sasha-nordiclab/noritsu-repair-parts/roller/README.md

# Noritsu QSF-V50 rack roller

Replacement film transport roller for the racks of the Noritsu QSF-V50 film processor. It is made of two printed parts:

- **Core (PETG):** the roller body on a Ø6 mm shaft, with end flanges and eight anti-rotation ribs.
- **Sleeve (TPU):** the rubber covering with a raised diamond grid, printed flat as a sheet and wrapped onto the core.

> **Status:** designed and checked in CAD (fits, overhangs, slicing). Not yet print-tested in the machine.

<p align="center">
  Assembled roller: PETG core with grid-textured TPU sleeve
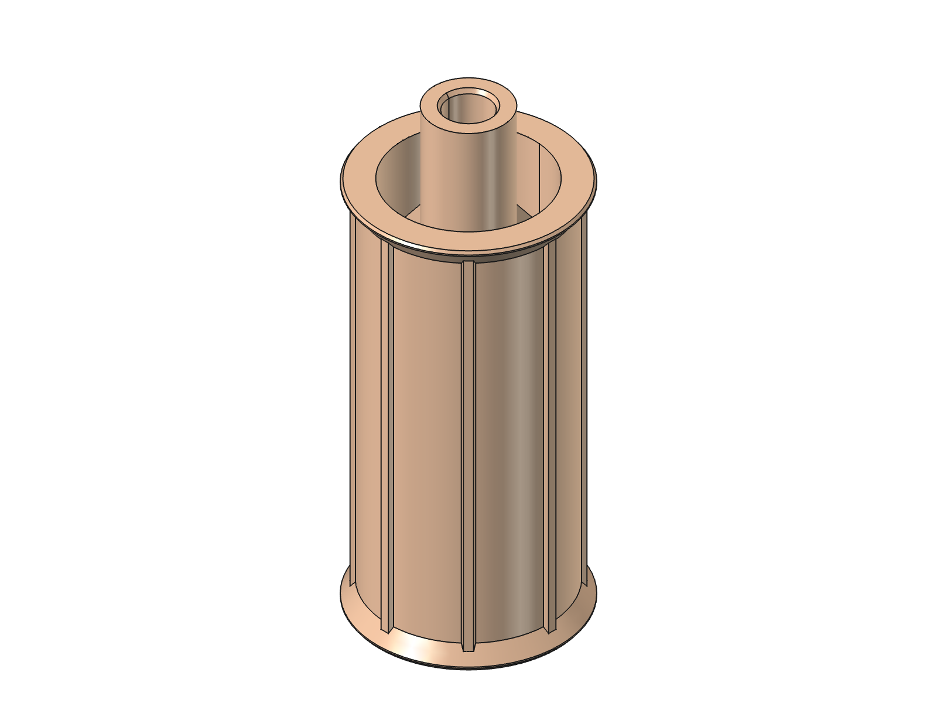
[picture p2: roller/docs/img/core_petg.png]
PETG core with eight grip ribs
  
</p>

## Files

| File | Use |
|---|---|
| [`step/Noritsu_V50_Roller_Core_PETG.step`](step/Noritsu_V50_Roller_Core_PETG.step) | Print: PETG core |
| [`step/Noritsu_V50_Roller_Sleeve_TPU_Flat.step`](step/Noritsu_V50_Roller_Sleeve_TPU_Flat.step) | Print: TPU sleeve as a flat sheet |
| [`step/Noritsu_V50_Roller_Assembly.step`](step/Noritsu_V50_Roller_Assembly.step) | Reference: core with the fitted, textured sleeve |
| [`step/Noritsu_V50_Roller_Sleeve_TPU_Fitted.step`](step/Noritsu_V50_Roller_Sleeve_TPU_Fitted.step) | Reference: the sleeve as it sits on the core |
| [`step/Noritsu_V50_Roller_Design_Reference.step`](step/Noritsu_V50_Roller_Design_Reference.step) | Reference: the original roller geometry before print optimisation (1 mm mid-length partition, Ø6 bore) |
| [`step/Noritsu_V50_Original_Sleeve_TPU_Flat.step`](step/Noritsu_V50_Original_Sleeve_TPU_Flat.step) | Print: TPU sleeve for the original roller, flat sheet |
| [`step/Noritsu_V50_Original_Assembly.step`](step/Noritsu_V50_Original_Assembly.step) | Reference: original roller with its fitted, textured sleeve |
| [`step/Noritsu_V50_Original_Sleeve_TPU_Fitted.step`](step/Noritsu_V50_Original_Sleeve_TPU_Fitted.step) | Reference: that sleeve as it sits on the original roller |
| [`step/Noritsu_V50_Roller_Sleeve_TPU_Smooth_Flat.step`](step/Noritsu_V50_Roller_Sleeve_TPU_Smooth_Flat.step) | Print: smooth TPU sleeve (no grid), flat sheet |
| [`step/Noritsu_V50_Original_Sleeve_TPU_Smooth_Flat.step`](step/Noritsu_V50_Original_Sleeve_TPU_Smooth_Flat.step) | Print: smooth TPU sleeve for the original roller, flat sheet |
| [`step/Noritsu_V50_Roller_Smooth_Assembly.step`](step/Noritsu_V50_Roller_Smooth_Assembly.step) · [`step/Noritsu_V50_Original_Smooth_Assembly.step`](step/Noritsu_V50_Original_Smooth_Assembly.step) | Reference: both rollers with the smooth sleeve fitted |
| [`step/Noritsu_V50_Roller_Dovetail_Core_PETG.step`](step/Noritsu_V50_Roller_Dovetail_Core_PETG.step) | Print: PETG core with dovetail slot |
| [`step/Noritsu_V50_Roller_Dovetail_Sleeve_TPU_Flat.step`](step/Noritsu_V50_Roller_Dovetail_Sleeve_TPU_Flat.step) | Print: smooth TPU sleeve with dovetail ends, flat sheet |
| [`step/Noritsu_V50_Roller_Dovetail_Assembly.step`](step/Noritsu_V50_Roller_Dovetail_Assembly.step) | Reference: dovetail core with the sleeve fitted |
| [`cad/NoritsuV50_Roller.FCStd`](cad/NoritsuV50_Roller.FCStd) | Parametric FreeCAD model with all of the above |

## Main dimensions

| | |
|---|---|
| Shaft / bore | Ø6 mm shaft, Ø6.5 mm printed bore (free running) |
| Running diameter | Ø26.5 mm core, about Ø30.9 mm over the grid |
| Flanges | Ø30 mm, 0.6 mm thick, 40° cones underneath |
| Length | 60 mm between flange faces, 70.4 mm with the hub stub |
| Hub | Ø11.3 mm, 2.4 mm wall; free for 5 mm at both ends (end recesses) |
| Grip ribs | 8 × trapezoid, 1.8 mm base, 1.2 mm top, 0.6 mm high |
| Sleeve | 1.2 mm base + 1 mm raised diamond grid: ribs 1.2 mm wide (2 lines of 0.6 mm) at ±45°, 3 mm pitch, 21 cells around |

## Core (PETG)

<p align="center">
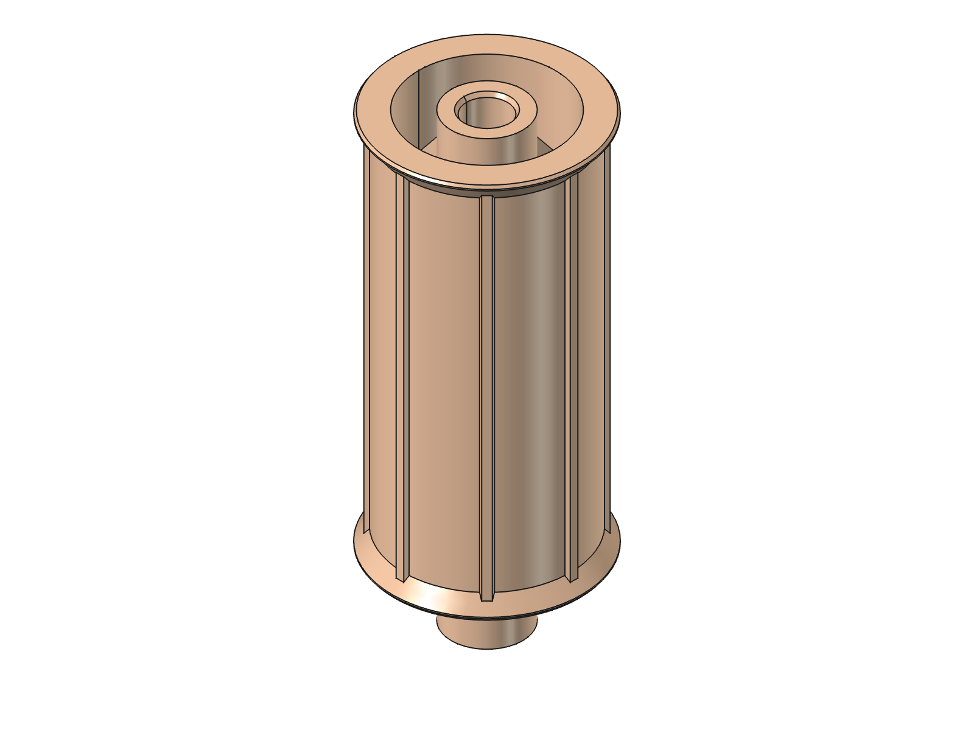
[picture p3: roller/docs/img/core_petg_bottom.png]
Core seen from the bottom end: end recess around the hub and spokes
  
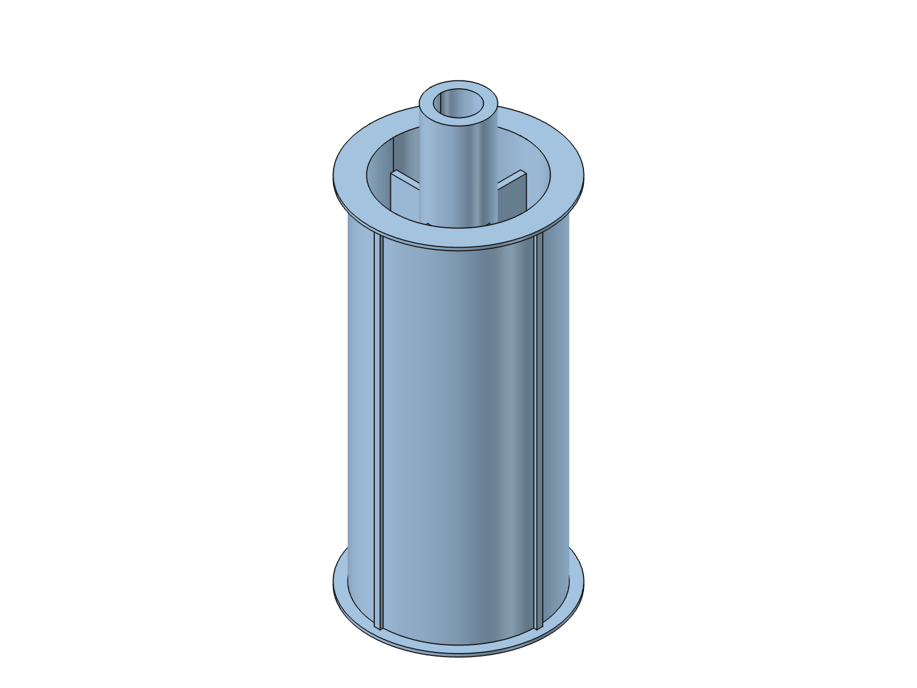
[picture p4: roller/docs/img/design_reference.png]
Original roller design before print optimisation
  
</p>

- **Orientation:** bottom end face on the bed, roller axis vertical. No supports: every overhang is 40° or less from vertical.
- **Inside:** four spokes join the hub to a 2.4 mm shell. A 2 mm web at mid-length closes the cavities; its underside is a tapered roof, so it prints without bridging. The 5 mm end recesses around the hub are the same depth at both ends.
- **Slicing (measured):** OrcaSlicer, Bambu Lab A1 0.4 nozzle, *0.20mm NordicLab 0.6 Ballance*, AzureFilm PETG HF: **1 h 25 min, 24.6 g**. The walls are all perimeters, so forcing solid walls does not change the result.

## Sleeve (TPU)

<p align="center">
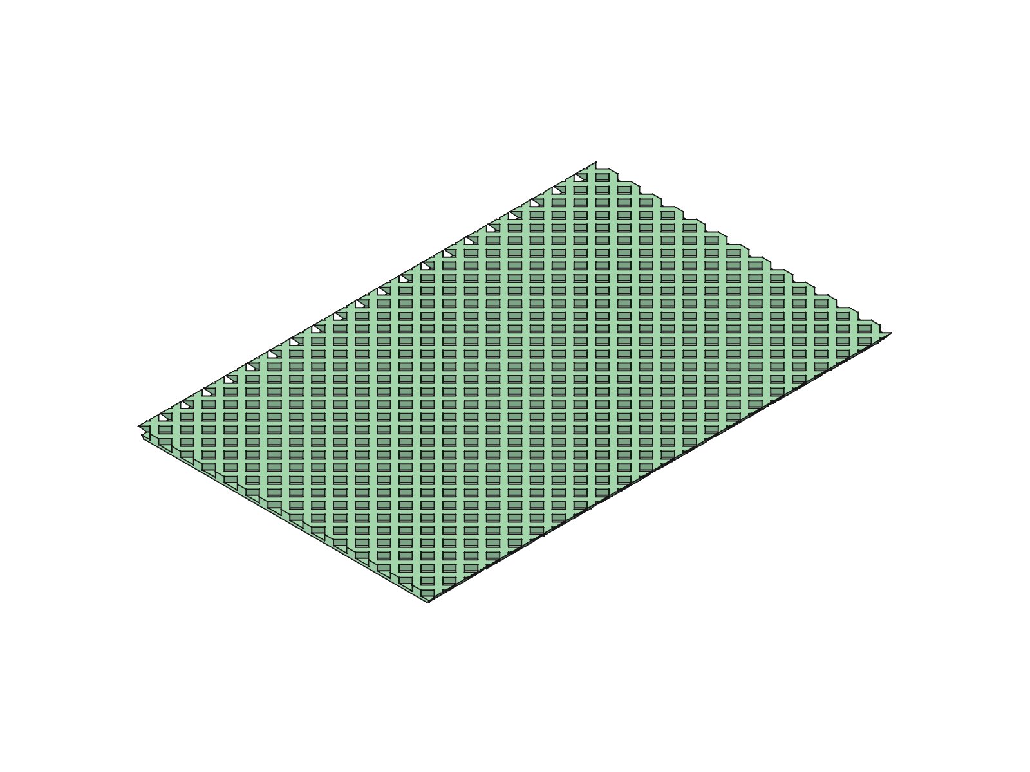
[picture p5: roller/docs/img/sleeve_flat_tpu.png]
Flat TPU sheet with raised diamond grid
  
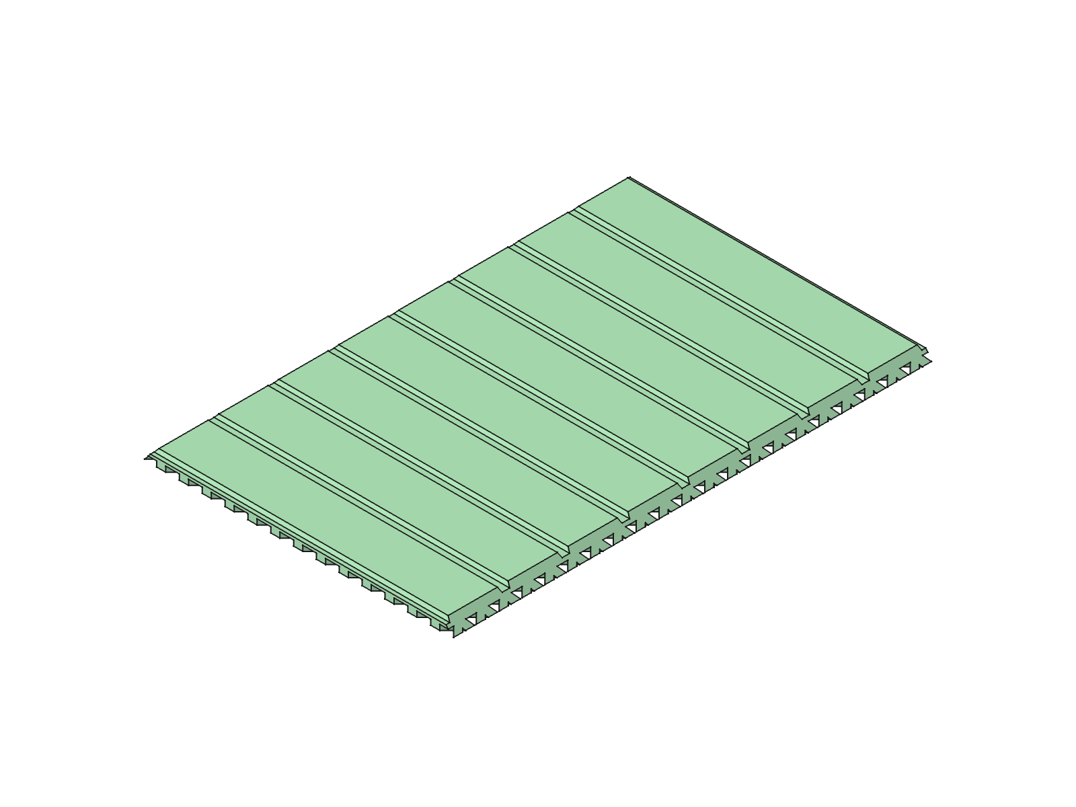
[picture p6: roller/docs/img/sleeve_flat_tpu_bottom.png]
Underside of the TPU sheet with eight rib grooves
  
</p>

- **Print flat:** inner face on the bed, grid up. The grid ribs have vertical walls and no tips, so every layer is a continuous path: it prints cleanly with a 0.6 mm nozzle and avoids the stringing TPU gets from many small islands. The sheet is 54.0 mm wide at the inner face and 89.55 mm long: the circumference at the neutral layer of the base plus grid (r ≈ 14.25 mm), rounded to 21 whole grid cells so the pattern meets at the seam. (v1.1 was 85.28 mm, about 4 mm too short: it ignored the grid when bending.)
- **Rib grooves:** eight grooves on the underside, with a half groove at each end so the seam lands on a rib. They have 0.1 mm clearance per side; the bevelled sheet ends leave 0.2 mm to each flange cone.
- **Slicing (measured):** *0.20mm NordicLab 0.6 Slow TPU*, AzureFilm TPU: **1 h 17 min, 10.7 g** with a 0.6 mm nozzle (Bambu Lab A1 0.6 nozzle), 1 h 28 min, 10.8 g with a 0.4 mm nozzle.
- **Assembly:** wrap the sheet onto the core with the grooves over the ribs and the seam on a rib. The flange cones hold both edges.

<p align="center">
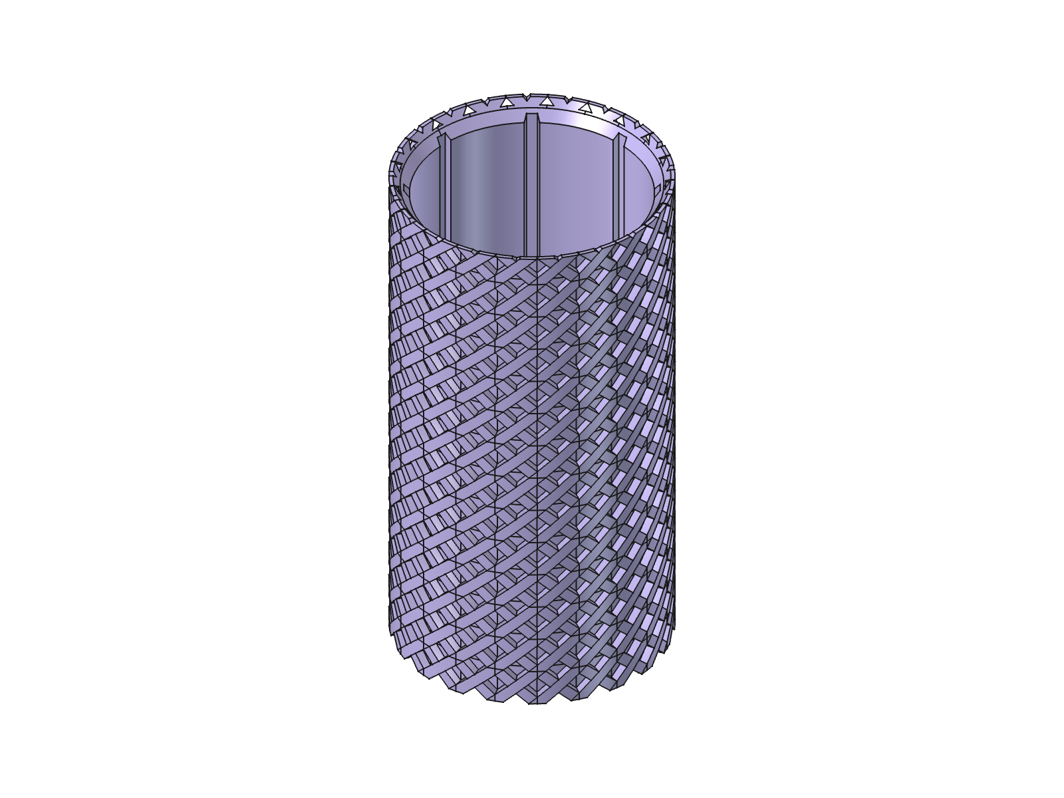
[picture p7: roller/docs/img/sleeve_fitted_tpu.png]
The sleeve as fitted on the core, with the grid
  
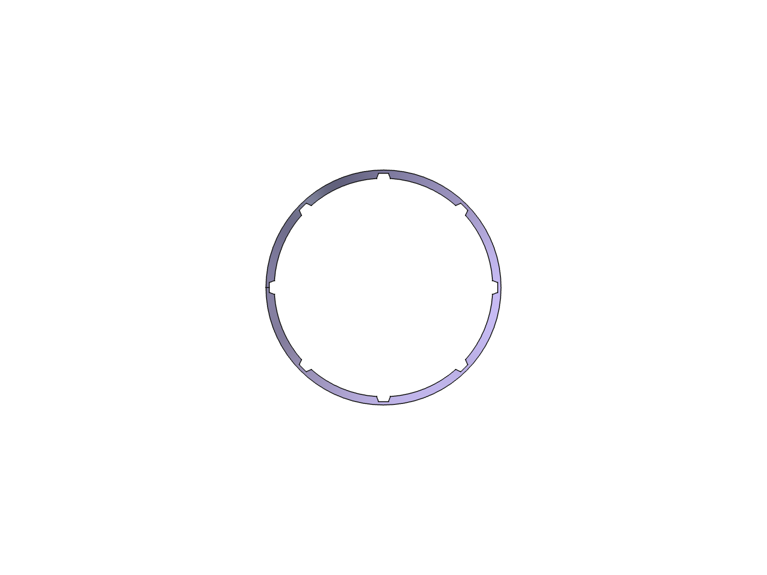
[picture p8: roller/docs/img/sleeve_fitted_tpu_inside.png]
Fitted sleeve seen along the axis: eight rib grooves
  
</p>

The fitted sleeve (`SleeveFittedGrid`) is a reference model with an exact, zero-clearance fit on the core. Its grid is built from one computed tile (an 18° piece with short helical ribs), repeated 294 times as linked copies, so the reference STEP files contain 295 solids. Use the flat sheet for printing.

## Sleeve for the original roller (TPU)

The same grid-textured TPU sleeve, made for the original roller geometry (`Roller`): flat Ø30 × 0.5 mm flanges without cones, and four rectangular ribs of 1 × 0.5 mm.

<p align="center">
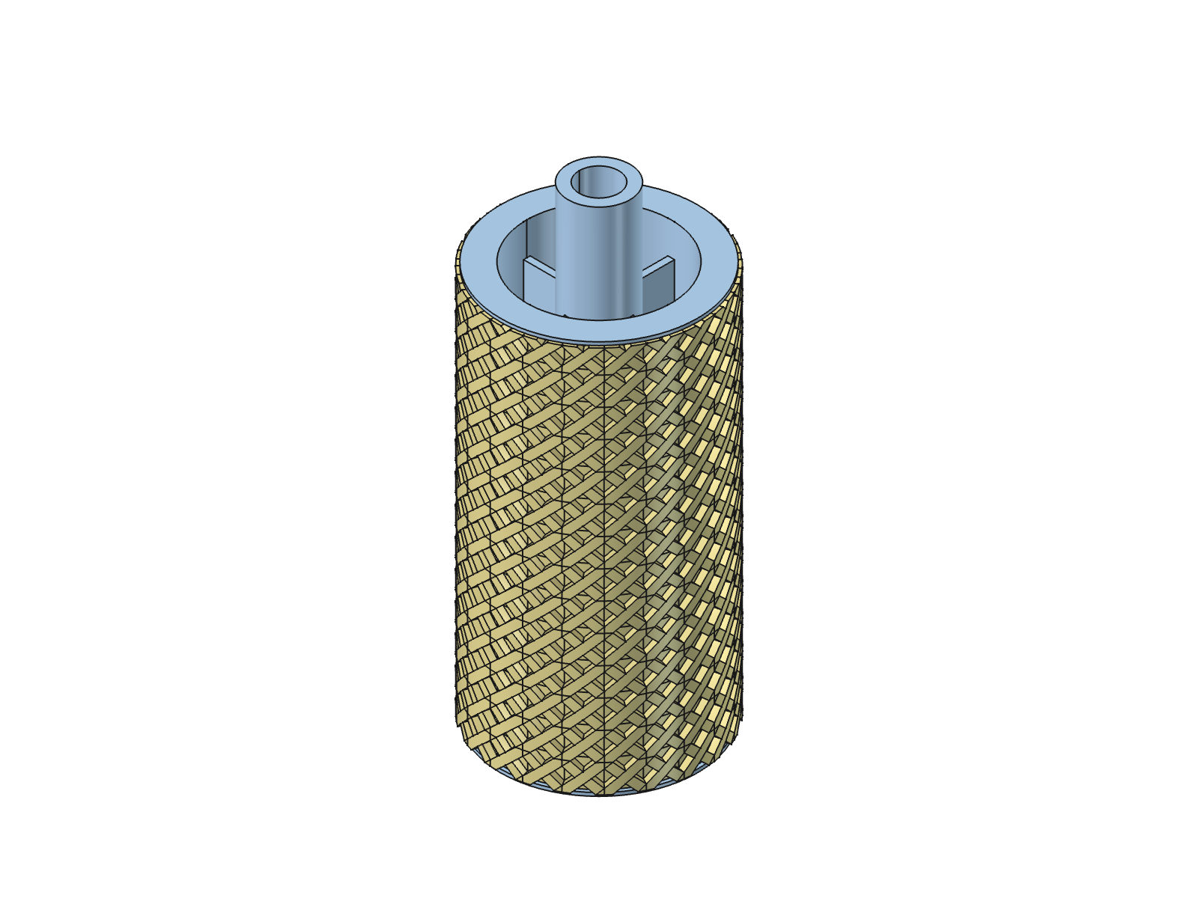
[picture p9: roller/docs/img/original_assembly.png]
Original roller with its grid-textured TPU sleeve
  
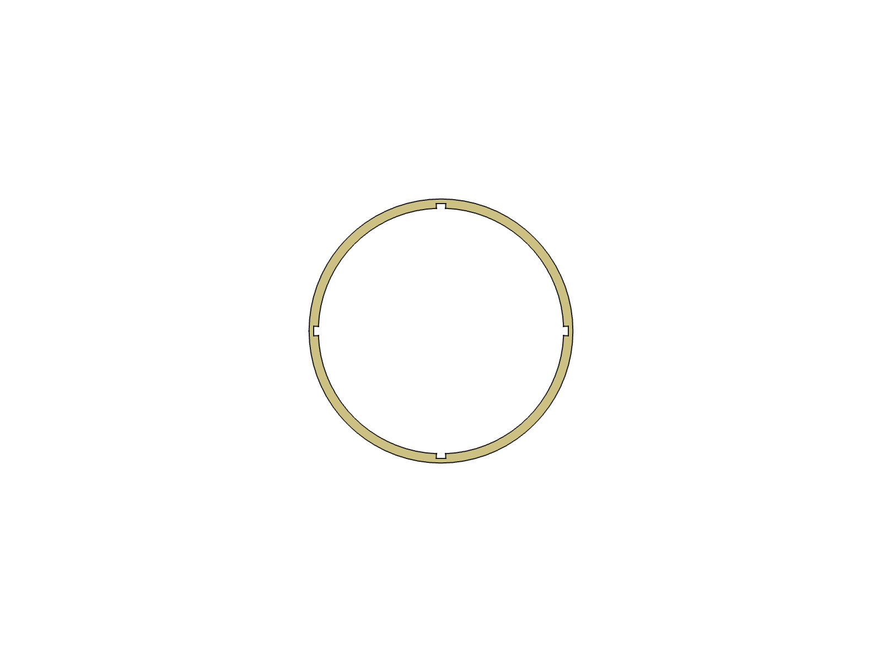
[picture p10: roller/docs/img/original_sleeve_fitted_tpu_inside.png]
Sleeve for the original roller seen along the axis: four rib grooves
  
</p>
<p align="center">
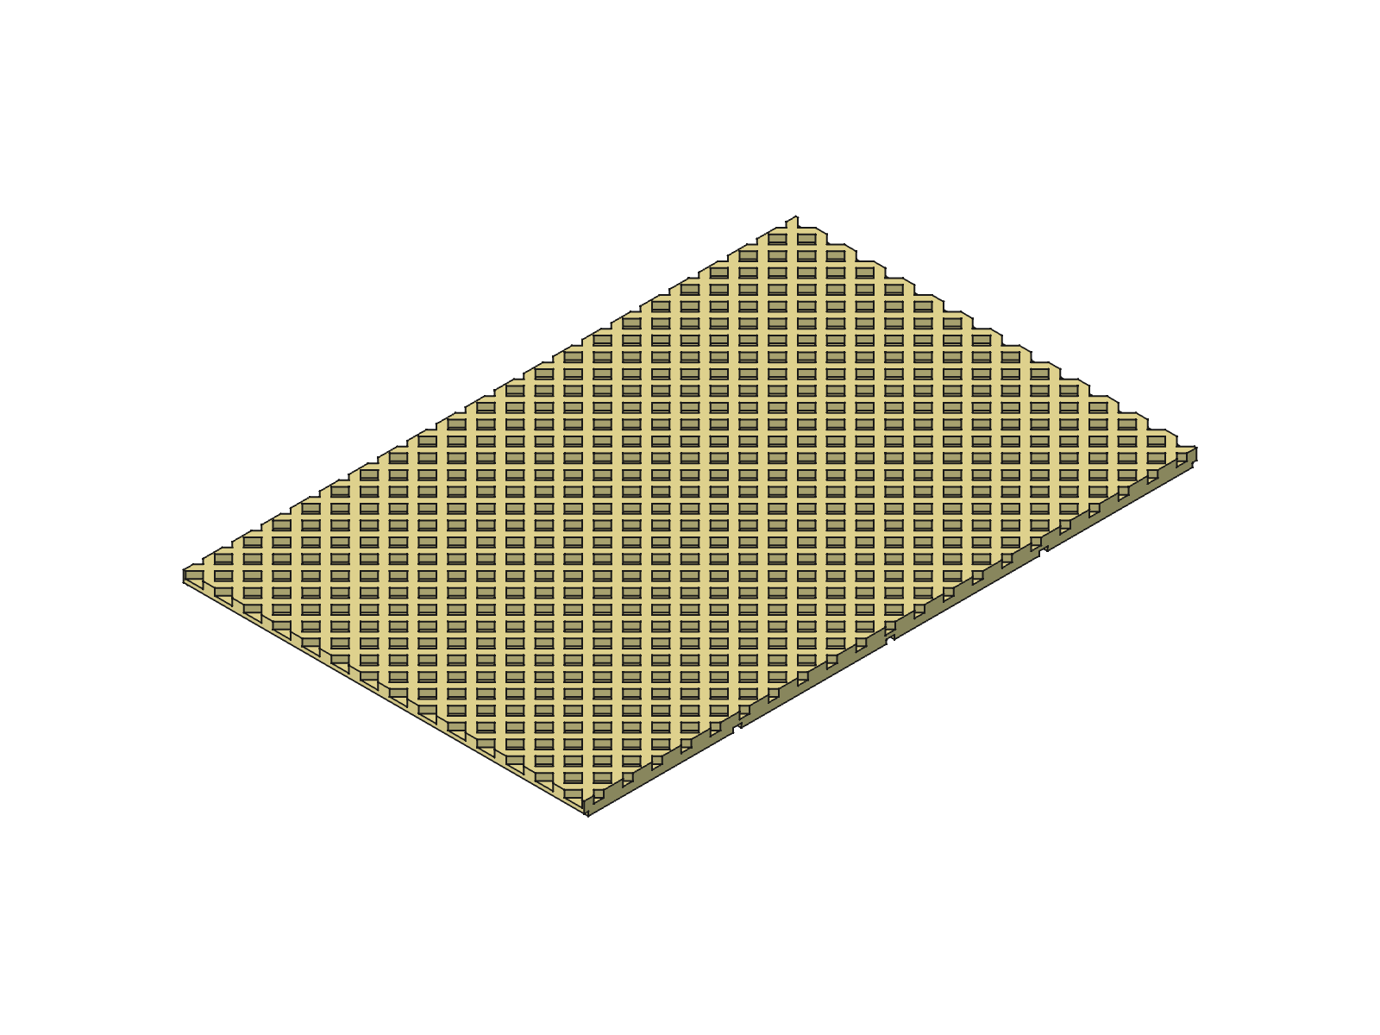
[picture p11: roller/docs/img/original_sleeve_flat_tpu.png]
Flat TPU sheet for the original roller
  
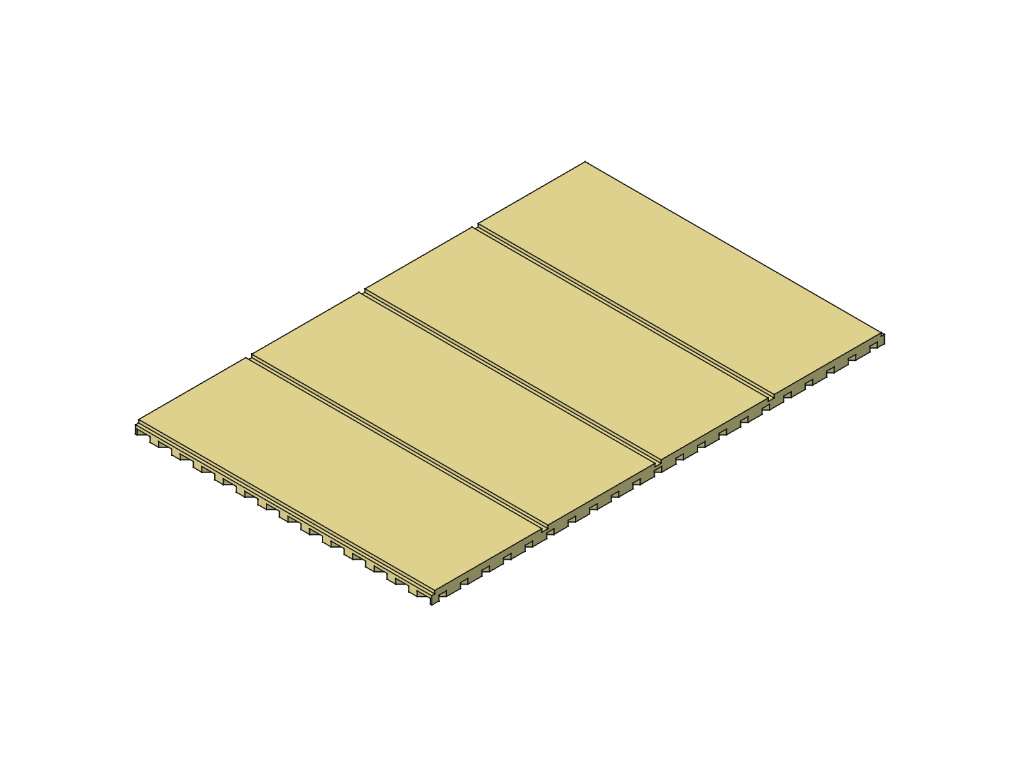
[picture p12: roller/docs/img/original_sleeve_flat_tpu_bottom.png]
Underside of that sheet with four rib grooves
  
</p>

- **Print flat:** the sheet is 58.6 mm wide (59 mm between the flanges, minus 0.2 mm at each end) and 89.55 mm long, with square ends because the flanges are flat. Base 1.2 mm, grid 1 mm.
- **Rib grooves:** four rectangular grooves 1.2 × 0.6 mm (0.1 mm clearance on each side and on top), with a half groove at each end so the seam lands on a rib. 0.6 mm of rubber remains over each groove.
- **Slicing (measured):** *0.20mm NordicLab 0.6 Slow TPU*, AzureFilm TPU: **1 h 19 min, 11.8 g** with a 0.6 mm nozzle, 1 h 24 min, 11.8 g with a 0.4 mm nozzle.
- **Fitted reference (`SleeveFittedOrig`):** exact zero-clearance fit on `Roller`, checked: no overlap and no void between roller and sleeve; the grid reuses the same tile as above plus one top tile trimmed at the flange, 294 linked copies.

## Smooth sleeve (TPU)

A variant without the grid: a plain 1.75 mm TPU sleeve with a smooth outer surface, for both rollers. Its thickness is (flange Ø − drum Ø)/2, so the fitted sleeve is Ø30 mm, flush with the flange rims, and the roller reads as one smooth cylinder. The rib grooves, clearances and seam-on-a-rib layout are the same as on the grid sheets, with 1.05 mm (print-optimised core) or 1.15 mm (original core) of rubber over each groove.

<p align="center">
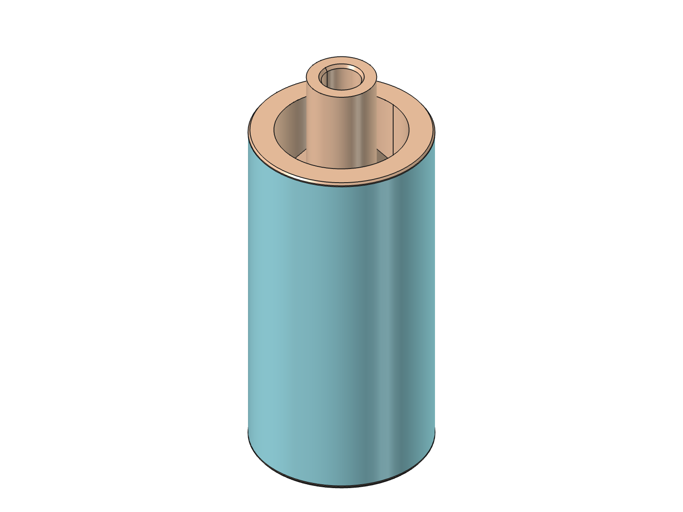
[picture p13: roller/docs/img/smooth_assembly.png]
Print-optimised core with smooth TPU sleeve
  
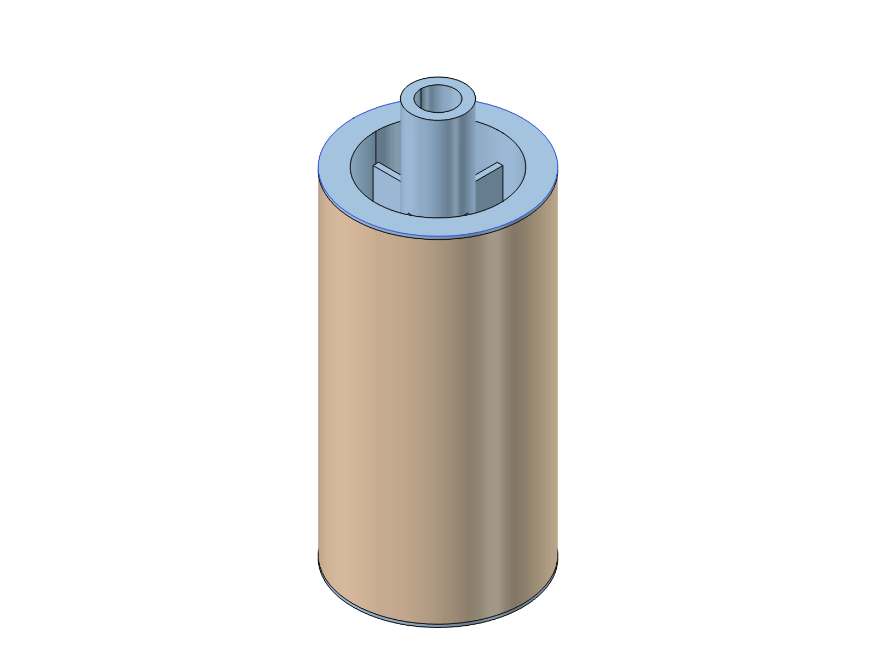
[picture p14: roller/docs/img/original_smooth_assembly.png]
Original roller with smooth TPU sleeve
  
</p>
<p align="center">
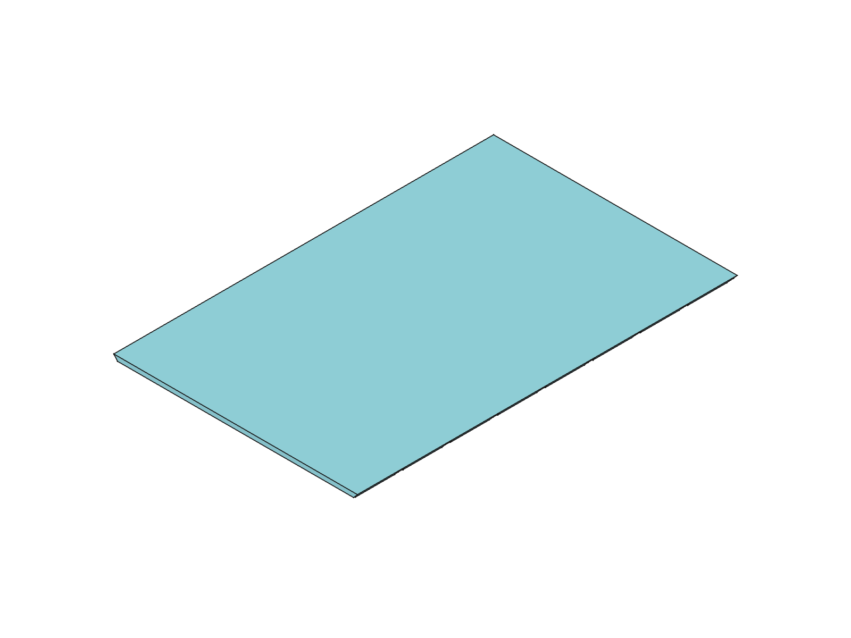
[picture p15: roller/docs/img/smooth_sleeve_flat_tpu.png]
Smooth TPU sheet
  
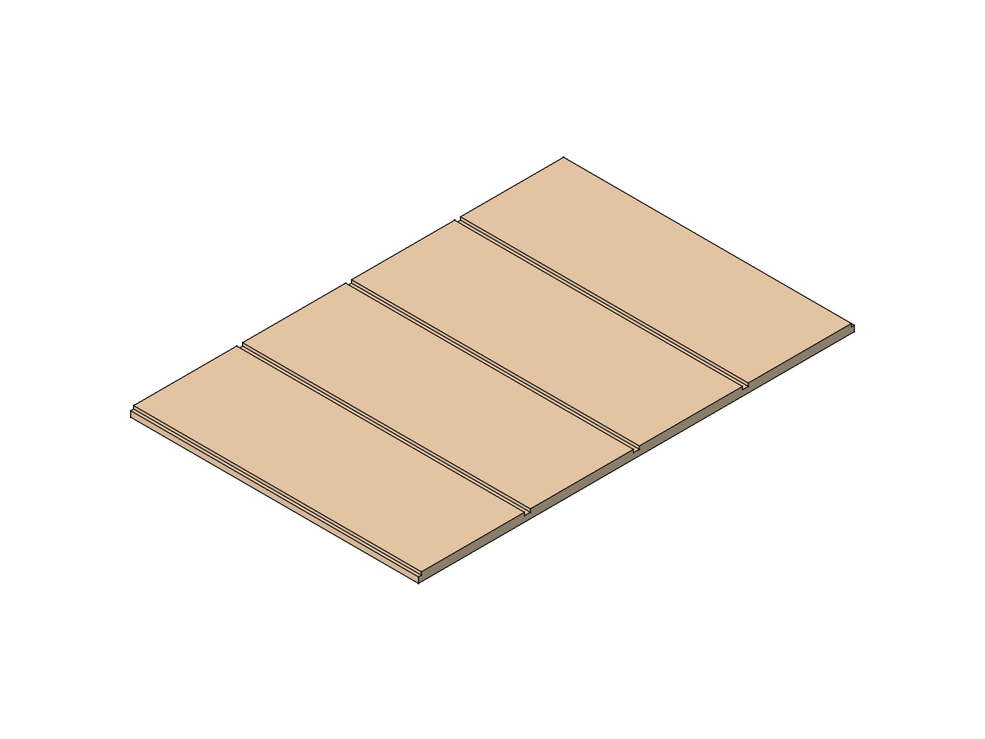
[picture p16: roller/docs/img/original_smooth_sleeve_flat_tpu.png]
Underside of the smooth sheet for the original roller with four rib grooves
  
</p>

- **Length:** 88.75 mm, the circumference at the middle of the 1.75 mm sheet (r 14.125 mm), where a plain sheet neither stretches nor compresses when wrapped. No preload.
- **Width:** 54.0 mm at the inner face with 40° bevelled ends (print-optimised core), 58.6 mm with square ends (original core).
- **Slicing (measured):** Bambu Lab A1 0.6 nozzle, *0.20mm NordicLab 0.6 Slow TPU*, AzureFilm TPU: **1 h 3 min, 10.2 g** (print-optimised core) and **1 h 6 min, 11.2 g** (original core).
- **Fitted references (`SleeveFittedSmooth`, `SleeveFittedSmoothOrig`):** exact zero-clearance fit, checked: no overlap and no void between roller and sleeve.

## Dovetail version (PETG core + smooth TPU sleeve)

A separate core in which one of the eight ribs is replaced by an axial dovetail slot, and a smooth sleeve whose two ends carry half-dovetail keys. Rolled up, the two ends meet and together form a full dovetail; slid onto the core from the top, the key runs along the slot and holds the seam closed, so the ends cannot pull out.

<p align="center">
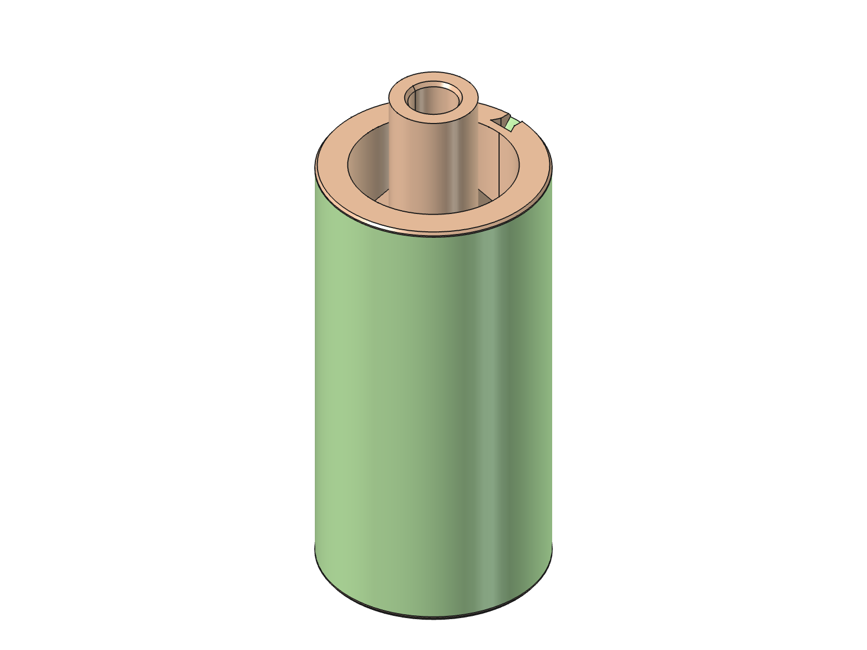
[picture p17: roller/docs/img/dovetail_assembly.png]
Dovetail core with the smooth sleeve fitted
  
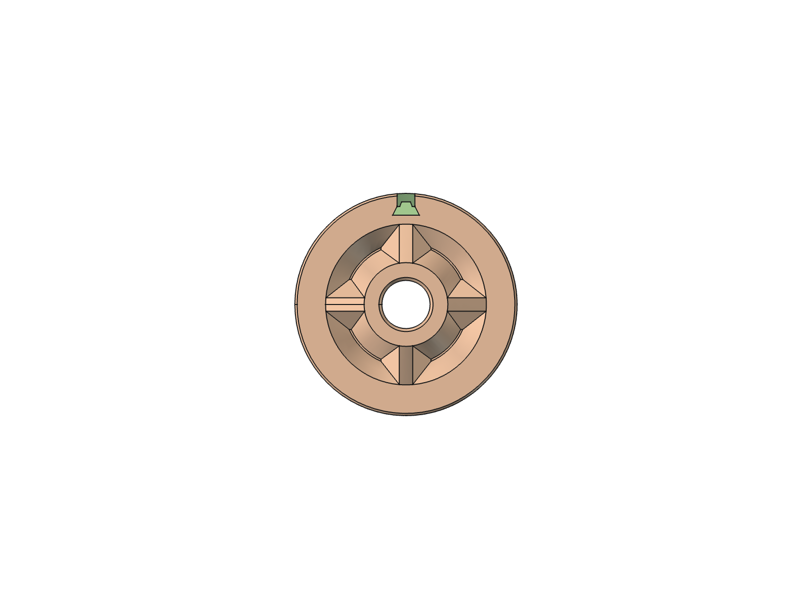
[picture p18: roller/docs/img/dovetail_assembly_top.png]
Top view: the joined sleeve keys sit in the dovetail slot
  
</p>
<p align="center">
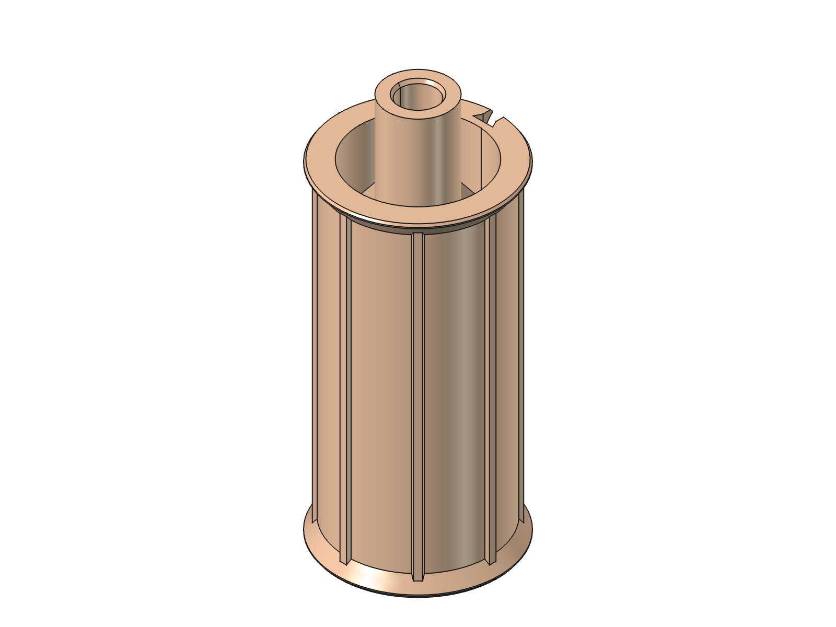
[picture p19: roller/docs/img/dovetail_core_petg.png]
PETG core with the dovetail slot open through the top flange
  
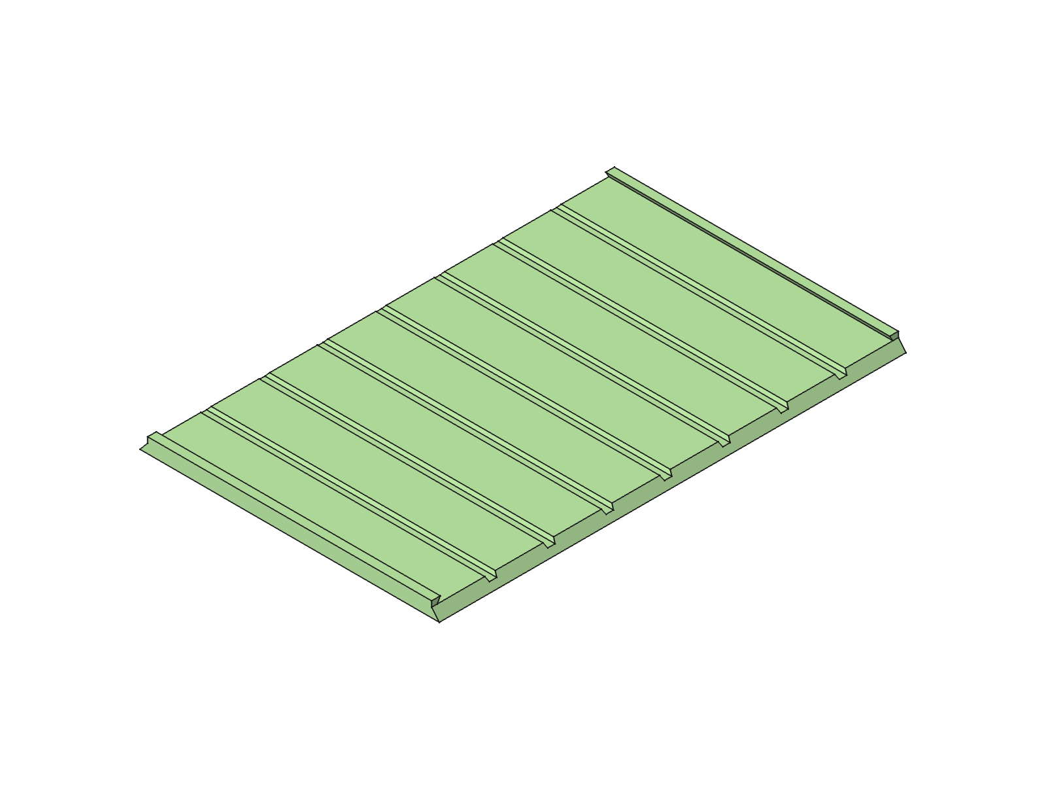
[picture p20: roller/docs/img/dovetail_sleeve_flat_tpu.png]
Flat sleeve printed key side up: half-dovetail keys at both ends, seven rib grooves
  
</p>

- **Slot (core):** 2.4 mm neck at the drum surface, 3.6 mm at the bottom, 1.2 mm deep, over a spoke. It is open through the top flange and closed at the bottom cone (z 2.8 mm), which works as the axial stop. Prints standing like the other core, no supports. *0.20mm NordicLab 0.6 Ballance*, PETG: **1 h 24 min, 24.3 g**.
- **Sleeve:** smooth 1.75 mm sheet (flush with the flanges), 88.75 mm long, seven rib grooves, and a half-dovetail key along each end (0.15 mm sliding clearance per side). Print it **outer face down, keys up**: the keys' slanted faces lean 30° from vertical. Bambu Lab A1 0.6 nozzle, *0.20mm NordicLab 0.6 Slow TPU*: **1 h 4 min, 10.9 g**.
- **Assembly:** roll the sheet into a tube so the two keys meet, then push the tube onto the core from the top end with the key in the slot, until it reaches the bottom stop. The sleeve has to stretch over the Ø30 mm top flange on the way.
- **Fitted reference (`SleeveFittedSmoothDovetail`):** exact zero-clearance fit on `RollerPrintDovetail`, checked: no overlap and no void, including the slot.

## Model notes

- All sizes are in the `params` spreadsheet: print-core values start with `p_`, grid sleeve with `sl_`, `kn_`, `grid_`, smooth sleeve with `t_smooth`/`sm_`, dovetail with `dt_`, original-roller variants with `o_`, fits with `fit_`.
- The model tree is grouped into folders: **01 Cores** (`Roller` original design, `RollerPrint`, `RollerPrintDovetail`), **02 Grid sleeve** (`SleeveFlatGrid…` print sheets, `SleeveFittedGrid…` + `SleeveGridTexture…` fitted references), **03 Smooth sleeve**, **04 Dovetail sleeve** and **05 Grid tiles** (hidden sources of the linked grid copies). "Orig" marks the parts for the original `Roller`.
- A ready-to-paste shop description is in [`docs/ko-fi-description.md`](docs/ko-fi-description.md).
- The grid links are placed by a script, not by expressions. After changing `kn_n`, `kn_s`, `p_fl` or `L_roll`, regenerate them as described in [`AGENTS.md`](../AGENTS.md).
