sasha-nordiclab/noritsu-repair-parts/roller/step/Noritsu_V50_Original_Smooth_Assembly.step

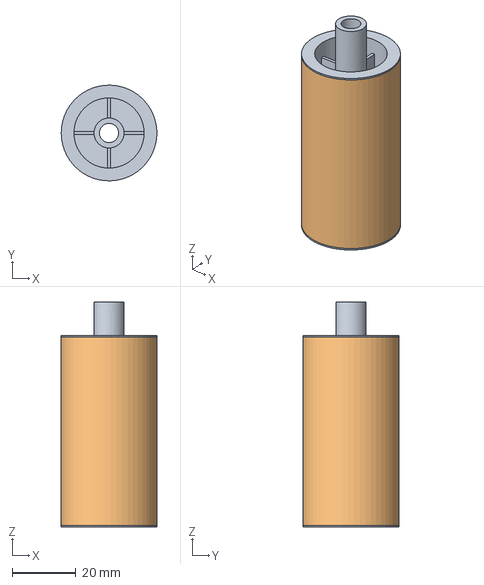
[picture p21: CAD file, 2026-10-15]
roller/step/Noritsu_V50_Original_Smooth_Assembly.step
30.0 x 30.0 x 70.5 mm
Roller
SleeveFittedSmoothOrig
