sasha-nordiclab/noritsu-repair-parts/roller/step/Noritsu_V50_Roller_Smooth_Assembly.step

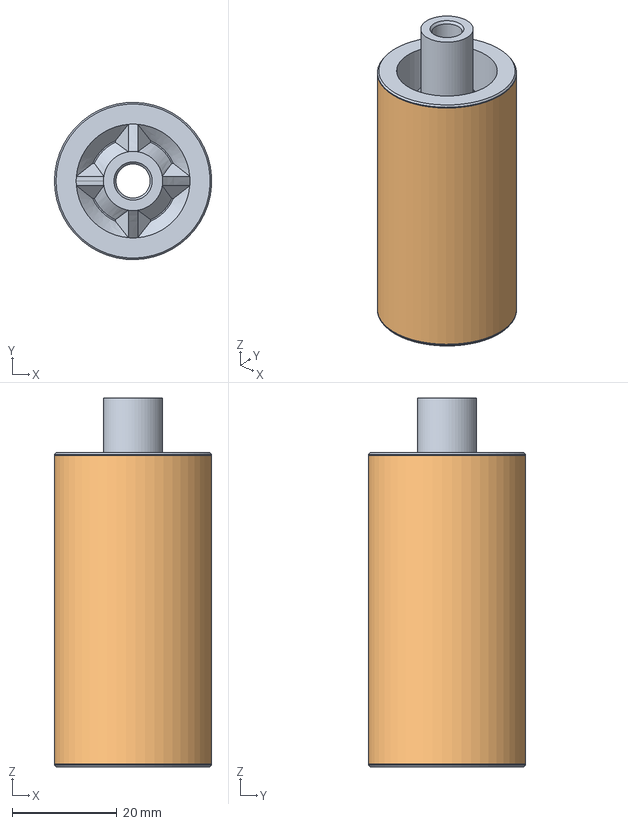
[picture p22: CAD file, 2026-10-15]
roller/step/Noritsu_V50_Roller_Smooth_Assembly.step
30.0 x 30.0 x 70.4 mm
RollerPrint
SleeveFittedSmooth
