sasha-nordiclab/noritsu-repair-parts/roller/step/Noritsu_V50_Original_Assembly.step

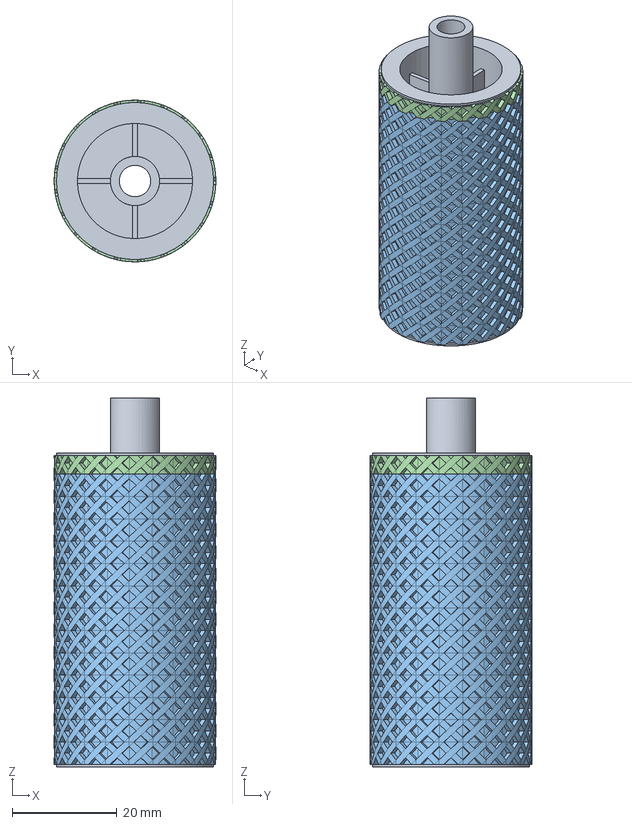
[picture p23: CAD file, 2026-10-15]
roller/step/Noritsu_V50_Original_Assembly.step
30.9 x 30.9 x 70.5 mm
Roller
SleeveFittedOrig
GridCell x 273
GridTopOrig x 21
