sasha-nordiclab/noritsu-repair-parts/roller/step/Noritsu_V50_Roller_Assembly.step

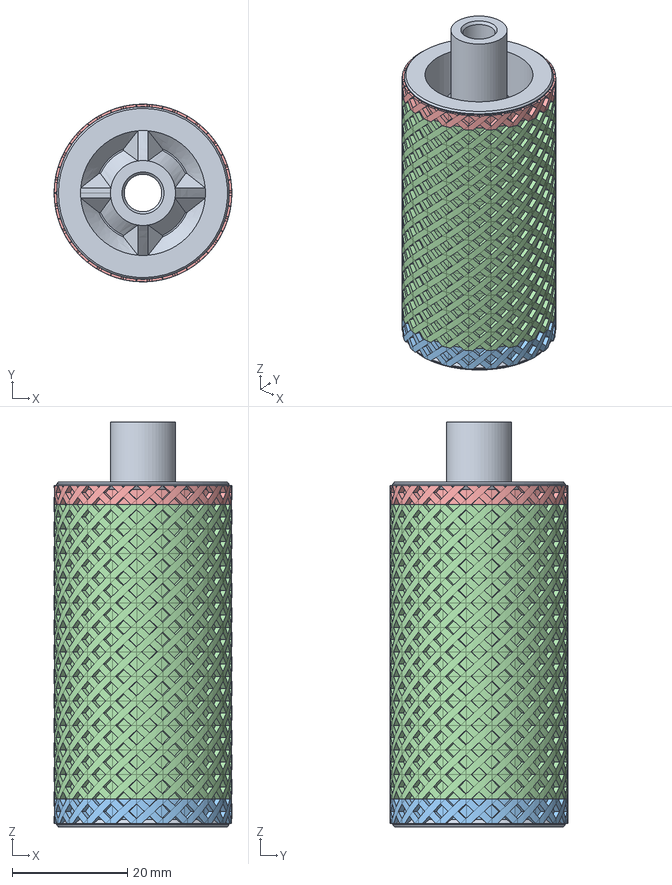
[picture p24: CAD file, 2026-10-15]
roller/step/Noritsu_V50_Roller_Assembly.step
30.9 x 30.9 x 70.4 mm
RollerPrint
SleeveFitted
GridLow x 21
GridCell x 252
GridHigh x 21
