sasha-nordiclab/noritsu-repair-parts/roller/cad/NoritsuV50_Roller.FCStd

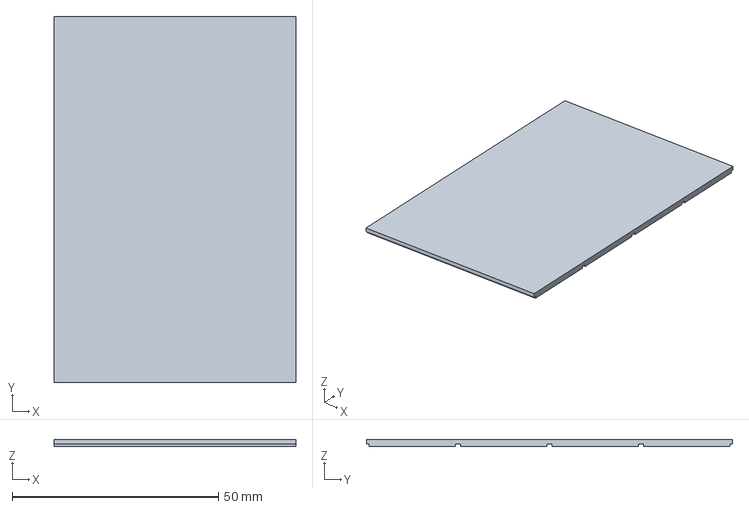
[picture p25: CAD file, 2026-10-15]
roller/cad/NoritsuV50_Roller.FCStd
58.6 x 88.7 x 1.75 mm
