sasha-nordiclab/noritsu-repair-parts/roller/step/Noritsu_V50_Roller_Sleeve_TPU_Smooth_Flat.step

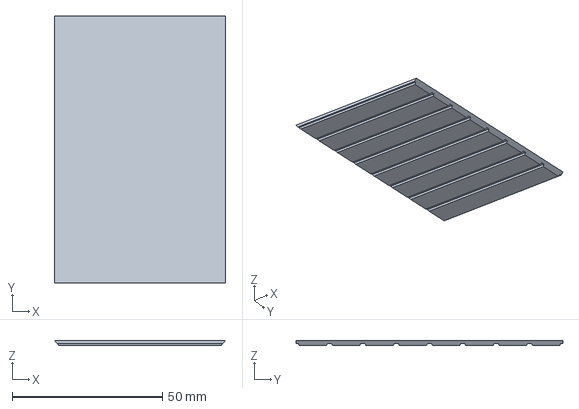
[picture p26: CAD file, 2026-10-15]
roller/step/Noritsu_V50_Roller_Sleeve_TPU_Smooth_Flat.step
56.9 x 88.7 x 1.75 mm
