sasha-nordiclab/noritsu-repair-parts/roller/step/Noritsu_V50_Roller_Dovetail_Sleeve_TPU_Flat.step

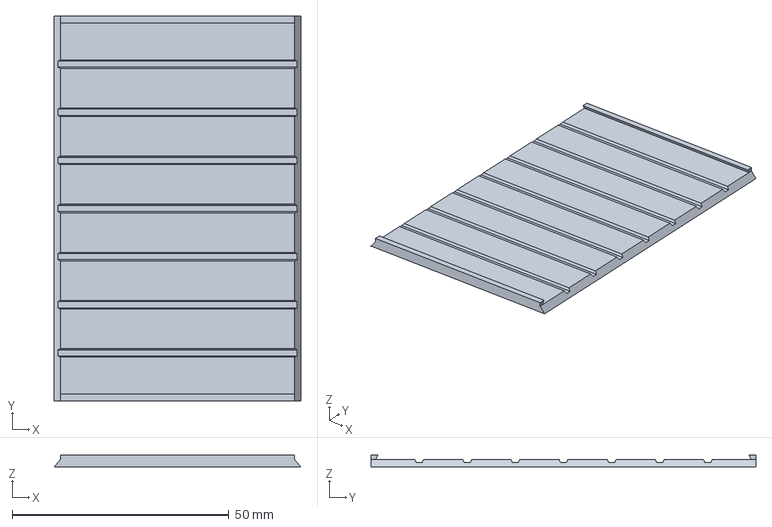
[picture p27: CAD file, 2026-10-15]
roller/step/Noritsu_V50_Roller_Dovetail_Sleeve_TPU_Flat.step
56.9 x 88.7 x 2.80 mm
