sasha-nordiclab/noritsu-repair-parts/roller/step/Noritsu_V50_Roller_Sleeve_TPU_Fitted.step

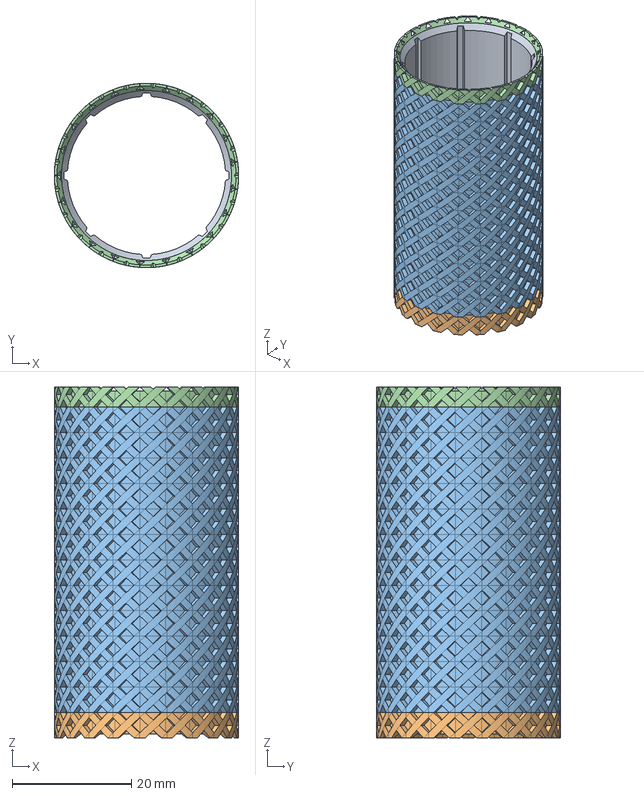
[picture p29: CAD file, 2026-10-15]
roller/step/Noritsu_V50_Roller_Sleeve_TPU_Fitted.step
30.9 x 30.9 x 58.8 mm
SleeveFitted
GridLow x 21
GridCell x 252
GridHigh x 21
