sasha-nordiclab/noritsu-repair-parts/roller/step/Noritsu_V50_Original_Sleeve_TPU_Flat.step

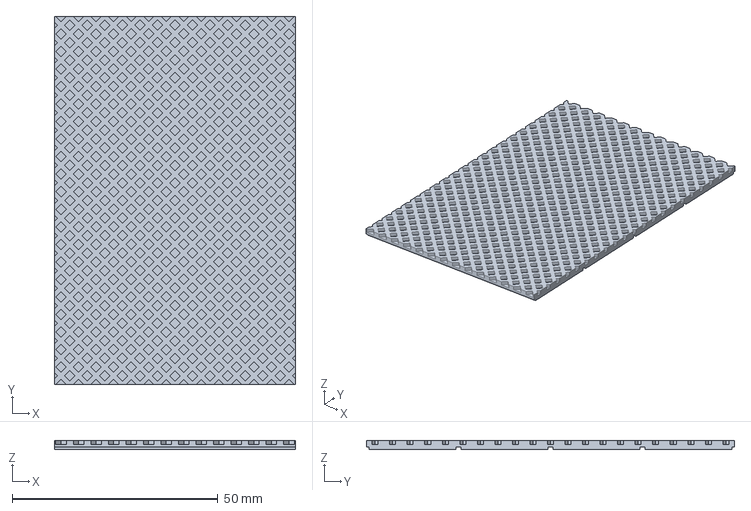
[picture p30: CAD file, 2026-10-15]
roller/step/Noritsu_V50_Original_Sleeve_TPU_Flat.step
58.6 x 89.5 x 2.20 mm
