sasha-nordiclab/noritsu-repair-parts/roller/step/Noritsu_V50_Roller_Sleeve_TPU_Flat.step

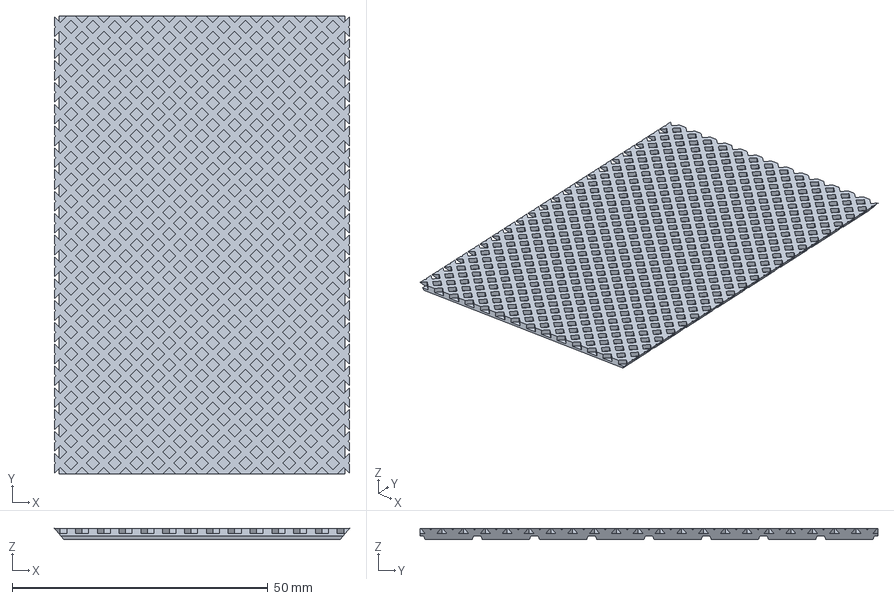
[picture p31: CAD file, 2026-10-15]
roller/step/Noritsu_V50_Roller_Sleeve_TPU_Flat.step
57.7 x 89.5 x 2.20 mm
