sasha-nordiclab/noritsu-repair-parts/roller/step/Noritsu_V50_Original_Sleeve_TPU_Fitted.step

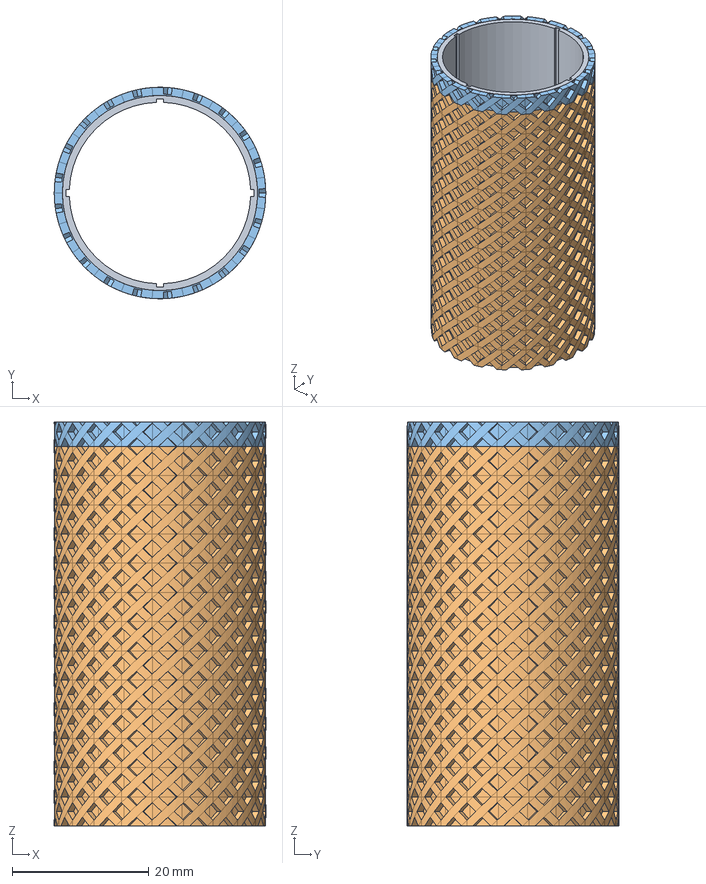
[picture p32: CAD file, 2026-10-15]
roller/step/Noritsu_V50_Original_Sleeve_TPU_Fitted.step
30.9 x 30.9 x 59.0 mm
SleeveFittedOrig
GridCell x 273
GridTopOrig x 21
