sasha-nordiclab/noritsu-repair-parts/roller/step/Noritsu_V50_Roller_Design_Reference.step

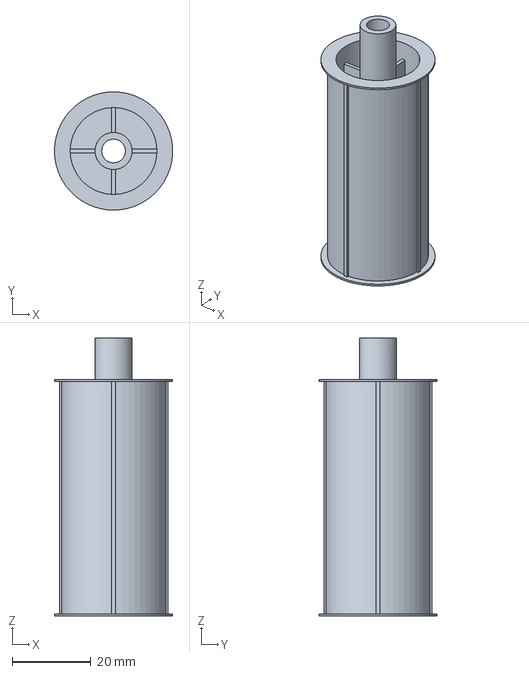
[picture p33: CAD file, 2026-10-13]
roller/step/Noritsu_V50_Roller_Design_Reference.step
30.0 x 30.0 x 70.5 mm
