sasha-nordiclab/noritsu-repair-parts/(list of files, cad)

Other CAD files:
roller/step/Noritsu_V50_Roller_Dovetail_Assembly.step
roller/step/Noritsu_V50_Original_Sleeve_TPU_Smooth_Flat.step
roller/step/Noritsu_V50_Roller_Core_PETG.step
