sasha-nordiclab/noritsu-repair-parts/(commit log)

2026-10-13 Initial import: Noritsu V50 parts and print-optimised roller core
    Roller: cleaned parametric design reference plus PETG print copy with
    symmetric flange cones, printable mid web and end recesses, 8 grip ribs.
    [NoritsuV50_Roller.fcstd]
2026-10-13 Add TPU rubber sleeve: flat printable sheet and fitted model
    Flat sheet: 8 anti-rotation rib grooves (seam on a rib), 1 mm diamond
    knurl from crossed 45 deg V-grooves, 40 deg bevelled ends.
    Fitted sleeve: untextured fit model, 0.1 mm rib clearance, no overlap.
    [NoritsuV50_Roller.fcstd]
2026-10-13 Make fitted sleeve an exact zero-clearance fit on the core
    Ends follow the flange cones, rib grooves equal the rib profile.
    Verified: no overlap and no void between core and sleeve.
    [NoritsuV50_Roller.fcstd]
2026-10-13 Save roller document (view state)
    [NoritsuV50_Roller.fcstd]
2026-10-13 Add knurl texture to the fitted sleeve as linked tiles
    One 12 deg x 2.843 mm tile (plus two end tiles trimmed to the flange
    cones) is cut by short helix pieces and repeated with App::Link arrays,
    avoiding the full-ring helix pattern that hung FreeCAD. Fitted sleeve
    base reduced by the 0.2 mm tile skin; no overlap with core or sleeve.
    [NoritsuV50_Roller.fcstd]
2026-10-13 Save roller document with texture view state
    [NoritsuV50_Roller.fcstd]
2026-10-13 Restructure into a parts repository with license and diff tooling
    Move the roller model to roller/cad/, license it CC BY-NC-SA 4.0 (also set
    in the document metadata), show only each body's tip feature, and add the
    FCStd textconv helper for readable diffs.
    [NoritsuV50_Roller.FCStd, NoritsuV50_Roller.fcstd]
2026-10-13 Add STEP exports for the roller
    PETG core and flat TPU sheet for printing; assembly, fitted sleeve and
    original design as references. Volumes verified against the model.
    [Noritsu_V50_Roller_Assembly.step, Noritsu_V50_Roller_Core_PETG.step, Noritsu_V50_Roller_Design_Reference.step, Noritsu_V50_Roller_Sleeve_TPU_Fitted.step, Noritsu_V50_Roller_Sleeve_TPU_Flat.step]
2026-10-13 Document the roller with renders, dimensions and print settings
2026-10-13 Restore the mid-length partition in the original roller design
    The 1 mm web at z 29.5-30.5 belongs to the original design; it was removed
    by mistake during cleanup. Rebuilt as two blind cavity pockets meeting at
    the web, and the design-reference STEP and render are updated.
    [NoritsuV50_Roller.FCStd, Noritsu_V50_Roller_Design_Reference.step]
2026-10-13 Add the knurled TPU sleeve for the original roller
    Flat printable sheet with four rectangular rib grooves and square ends for
    the flat flanges, plus an exact-fit textured reference on the original
    roller. STEP files, renders and print settings added.
    [NoritsuV50_Roller.FCStd, Noritsu_V50_Original_Assembly.step, Noritsu_V50_Original_Sleeve_TPU_Fitted.step, Noritsu_V50_Original_Sleeve_TPU_Flat.step]
2026-10-14 Replace the pyramid knurl with a raised diamond grid for 0.6 mm nozzles
    Grid ribs are 1.2 mm wide (two 0.6 mm lines), 1 mm high, at +/-45 deg with
    3 mm pitch and 20 cells around, so every layer is a continuous path. Flat
    sheets trim between the two rib directions to keep booleans small; fitted
    sleeves use one helical-rib tile repeated as 280 linked copies. STEP files,
    renders, slicing numbers (0.6 mm nozzle) and descriptions updated.
    [NoritsuV50_Roller.FCStd, Noritsu_V50_Original_Assembly.step, Noritsu_V50_Original_Sleeve_TPU_Fitted.step, Noritsu_V50_Original_Sleeve_TPU_Flat.step, Noritsu_V50_Roller_Assembly.step, Noritsu_V50_Roller_Sleeve_TPU_Fitted.step, Noritsu_V50_Roller_Sleeve_TPU_Flat.step]
2026-10-14 Finish the roller: final handoff state and v1.1 release link
    [NoritsuV50_Roller.FCStd]
2026-10-15 Fix flat sleeve length: size sheets at the neutral layer of base plus grid
    v1.1 sheets were 85.28 mm (middle of the base minus 2 % preload) and too
    short to close on the printed core. Now 89.55 mm = 21 grid cells of
    4.264 mm, matching the neutral layer of the 1.2 mm base plus 1 mm grid,
    with no preload. Fitted grid tiles rebuilt for 21 cells; STEP files,
    renders, slicing numbers and descriptions updated.
    [NoritsuV50_Roller.FCStd, Noritsu_V50_Original_Assembly.step, Noritsu_V50_Original_Sleeve_TPU_Fitted.step, Noritsu_V50_Original_Sleeve_TPU_Flat.step, Noritsu_V50_Roller_Assembly.step, Noritsu_V50_Roller_Sleeve_TPU_Fitted.step, Noritsu_V50_Roller_Sleeve_TPU_Flat.step]
2026-10-15 Add a smooth TPU sleeve variant for both rollers
    Plain 1.6 mm sheet (no grid on top), Ø29.7 mm fitted, flush inside the
    flanges, with the same rib grooves and seam layout. Length 88.28 mm at the
    mid-thickness neutral layer. Flat print sheets, exact-fit references,
    STEP files, renders and slicing numbers.
    [NoritsuV50_Roller.FCStd, Noritsu_V50_Original_Sleeve_TPU_Smooth_Flat.step, Noritsu_V50_Original_Smooth_Assembly.step, Noritsu_V50_Roller_Sleeve_TPU_Smooth_Flat.step, Noritsu_V50_Roller_Smooth_Assembly.step]
2026-10-15 Add a dovetail version: core slot plus sleeve with interlocking ends
    Separate PETG core with an axial dovetail slot (open through the top flange,
    stop at the bottom) and a smooth TPU sheet whose ends carry half-dovetail
    keys. Rolled up, the keys form one dovetail that slides into the slot and
    holds the seam closed. Exact-fit reference, STEP files, renders, slicing.
    [NoritsuV50_Roller.FCStd, Noritsu_V50_Roller_Dovetail_Assembly.step, Noritsu_V50_Roller_Dovetail_Core_PETG.step, Noritsu_V50_Roller_Dovetail_Sleeve_TPU_Flat.step]
2026-10-15 Restore the default view: print core with grid sleeve and flat sheet
    [NoritsuV50_Roller.FCStd]
2026-10-15 Make the smooth sleeves flush with the flange rims
    Smooth sleeve thickness is now (flange - drum diameter)/2 = 1.75 mm, so the
    fitted sleeve is Ø30 mm like the flanges. Applies to both smooth sheets and
    the dovetail sleeve; fits re-checked, STEP files, renders, slicing updated.
    [NoritsuV50_Roller.FCStd, Noritsu_V50_Original_Sleeve_TPU_Smooth_Flat.step, Noritsu_V50_Original_Smooth_Assembly.step, Noritsu_V50_Roller_Dovetail_Assembly.step, Noritsu_V50_Roller_Dovetail_Sleeve_TPU_Flat.step, Noritsu_V50_Roller_Sleeve_TPU_Smooth_Flat.step, Noritsu_V50_Roller_Smooth_Assembly.step]
2026-10-15 Clean up the roller model: drop unused params, group the tree, clarify labels
    Remove eight params left from earlier variants (pyramid knurl, preload,
    old fit profile), sort the 17 bodies into five folders, label the grid
    sleeve bodies '...Grid', and rewrite AGENTS.md as a concise current handoff.
    [NoritsuV50_Roller.FCStd]
